NathanWang2/Senior-Design/Site/readme.md

Thanks for downloading this theme!

Get more freebies, collection from http://bootstraptaste.com
