NathanWang2/Senior-Design/Site/img/dummies/blog/img1.jpg

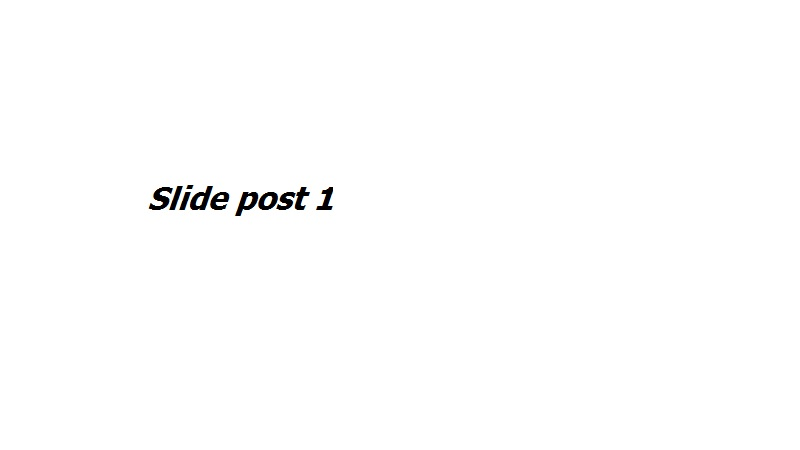
Site/img/dummies/blog/img1.jpg
