NathanWang2/Senior-Design/Site/img/slides/3.jpg

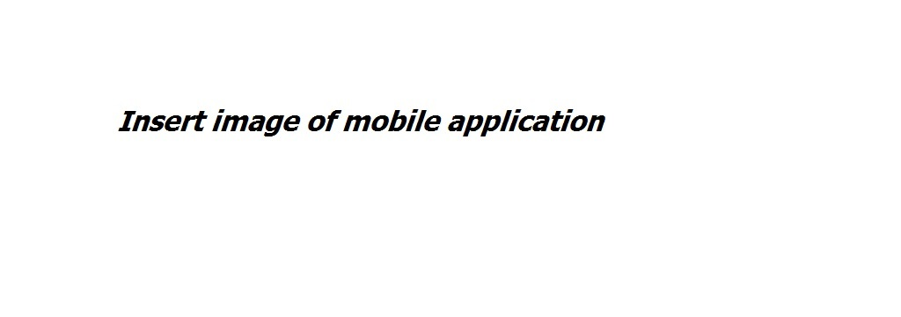
Site/img/slides/3.jpg
