NathanWang2/Senior-Design/Site/img/works/1.jpg

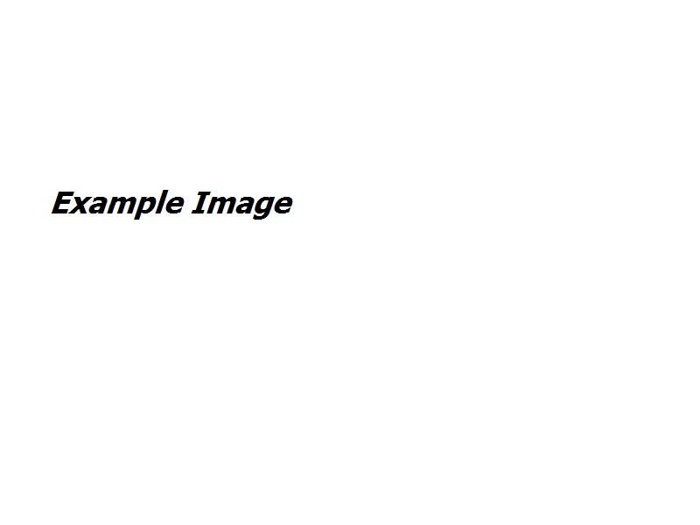
Site/img/works/1.jpg
