NathanWang2/Senior-Design/Thermostat/tcp_server.py

import socket
import sys
import time

sock = socket.socket(socket.AF_INET, socket.SOCK_STREAM)

server_address = ('192.168.43.51', 10000)
print >>sys.stderr, 'starting up on %s port %s' % server_address
sock.bind(server_address)

sock.listen(1)

while True:
    print >>sys.stderr, 'waiting for connection'
    connection, client_address = sock.accept()

    try:
        print >>sys.stderr, 'connection from', client_address

        while True:
            data = connection.recv(16)
            print >>sys.stderr, 'received "%s"' % data
            if data:
                print >>sys.stderr, 'sending data back to the client'
                connection.sendall(data)
            else:
                print >>sys.stderr, 'no more data from', client_address
                break

    finally:
        connection.close()

    time.sleep(1)
