NathanWang2/Senior-Design/(commit log)

2016-11-02 Adding all new temp probe and thermostat gui stuff
2016-11-03 reading temperature from probe
2016-11-17 Added a refresh button
